SkillsHUB-Electronics/smart-fog-detector-and-illumination-v1/drivers/README.txt

Put the USB-serial driver you downloaded from the VENDOR'S OFFICIAL page here:
  - the installer (for example CH341SER.EXE), or
  - the unzipped driver folder (it contains .inf files).
Then open the dashboard > Settings > USB-serial driver and click Install.
Windows will ask for administrator approval (UAC). Nothing here is run automatically.
