SkillsHUB-Electronics/smart-fog-detector-and-illumination-v1/docs/flowchart.png

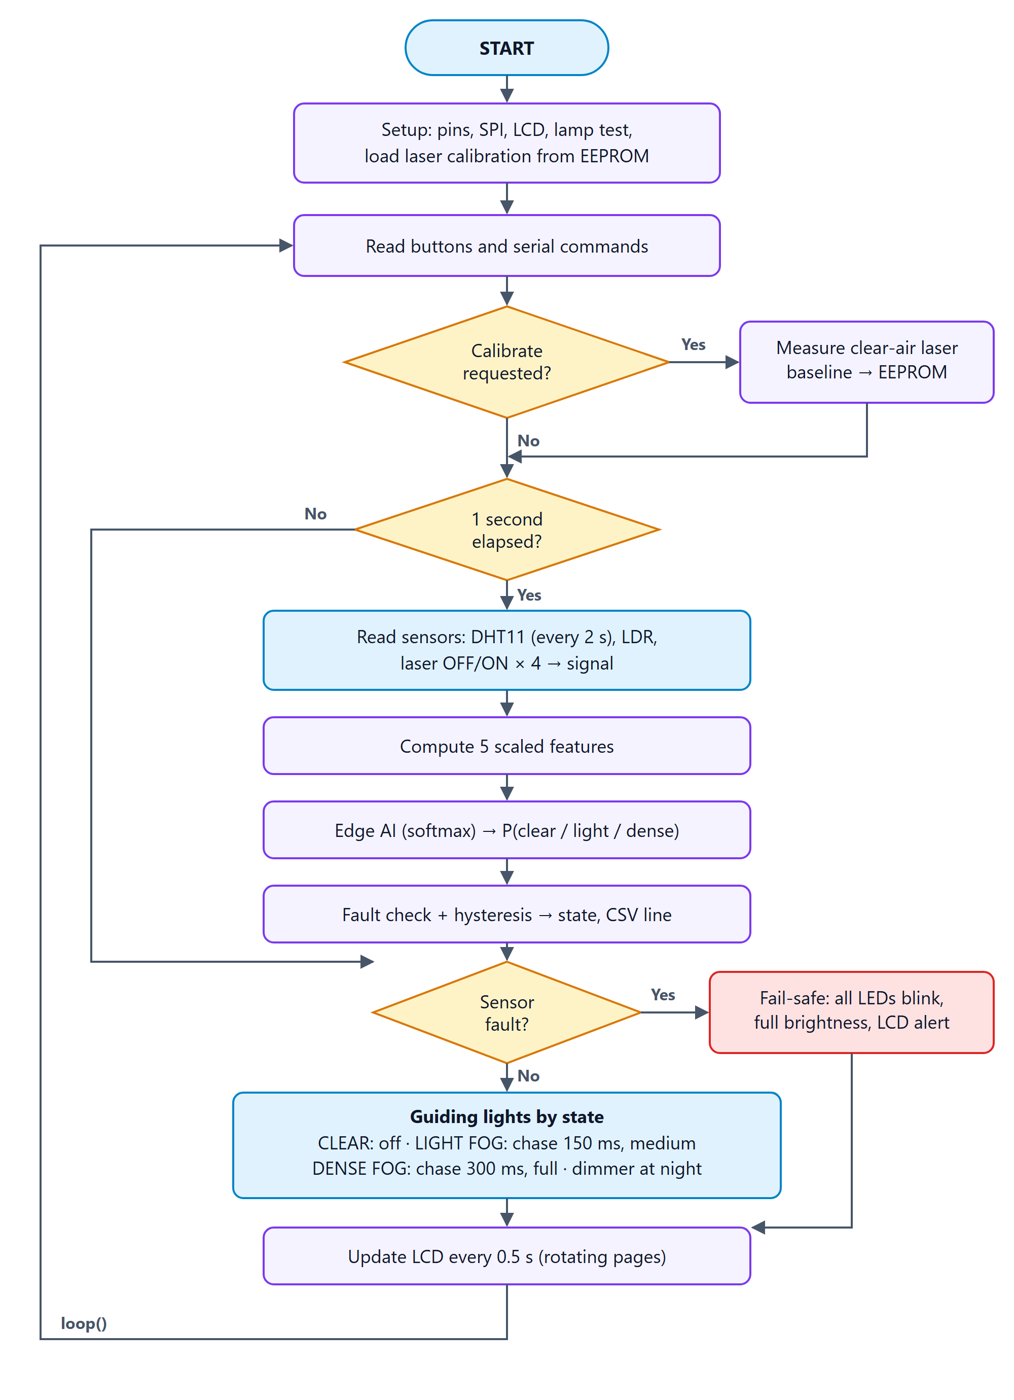
docs/flowchart.png
