SkillsHUB-Electronics/smart-fog-detector-and-illumination-v1/docs/wiring_diagram.png

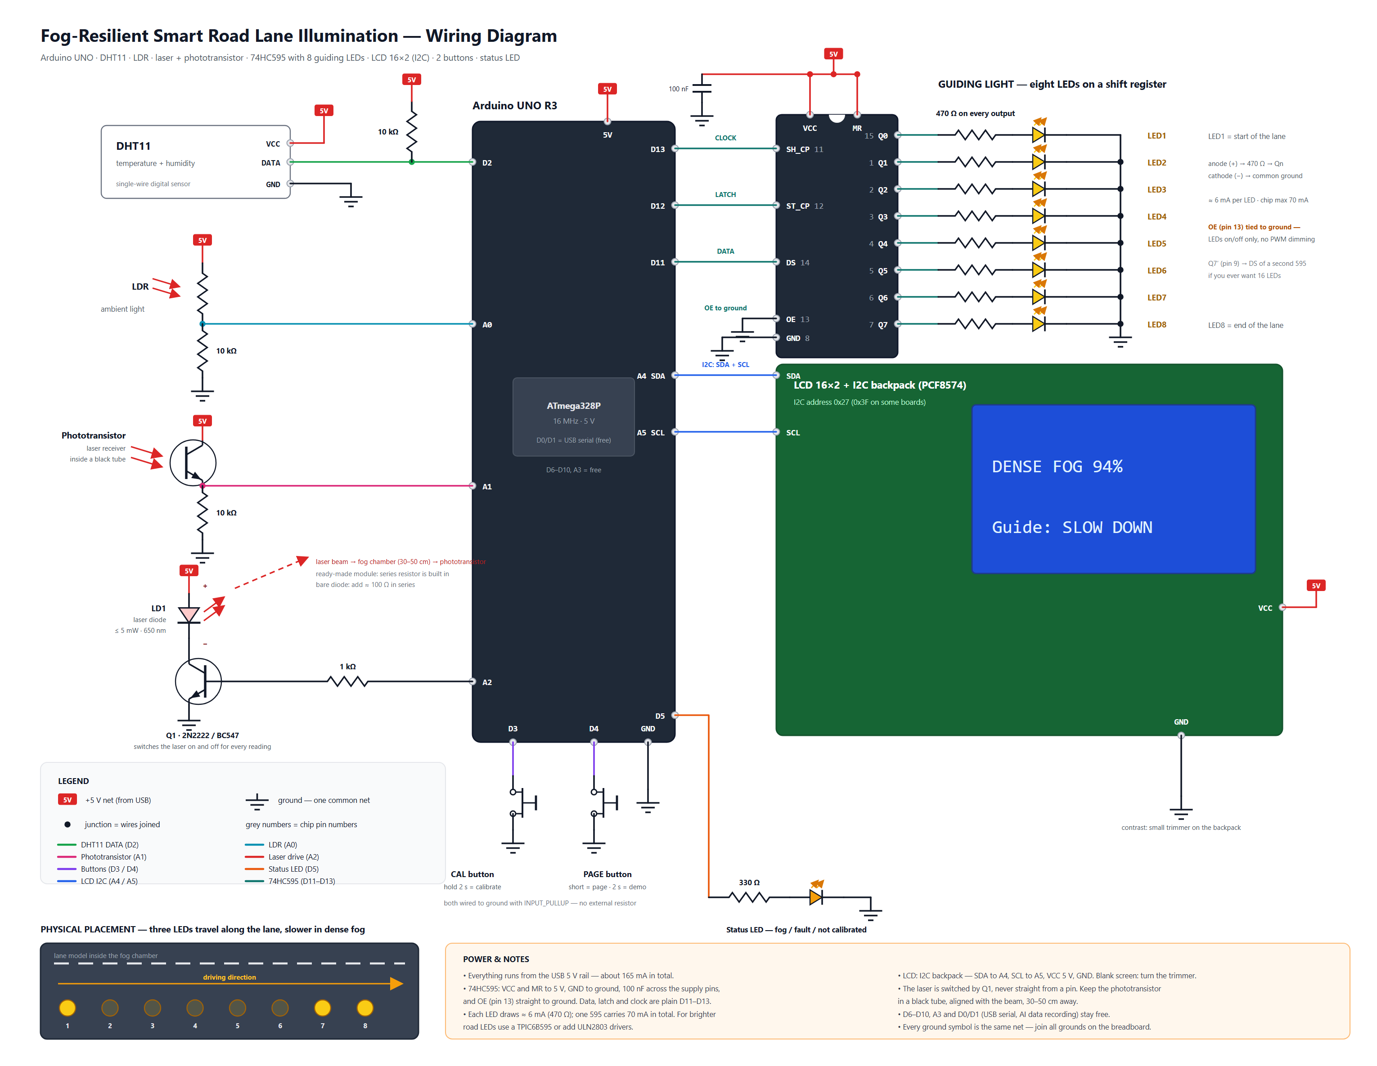
docs/wiring_diagram.png
