SkillsHUB-Electronics/smart-fog-detector-and-illumination-v1/(commit log)

2026-10-19 Smart fog detector and lane illumination: Arduino Uno firmware, tools, PC dashboard
    - firmware/fog_illumination_uno: DHT11 + laser transmission + LDR sensing, edge-AI
    (softmax) fog classifier, 74HC595 chasing guide lights, fail-safe rules,
    calibration checks, EEPROM settings over serial (!get / !set / !reset)
    - tools: serial recorder, model training, stdlib serial port access
    - dashboard: stdlib server with live view, settings over USB serial, recording,
    firmware simulator and USB-serial driver helper (START_DASHBOARD.bat)
    - docs: wiring, block and flow diagrams; README.id.md (Indonesian guide)
    [config.h, drivers.py, fog_illumination_uno.ino, model_weights.h, record_data.py, serial_port.py, server.py]
2026-10-19 Add calibration, learning and firmware upload to the dashboard
    - firmware: calibration.h (LDR limits, DHT11 gain/offset) applied to the light
    feature and the DHT11 readings; K line reports the compiled calibration
    - dashboard: Calibration page (two-point linearisation, save to calibration.h,
    compile + upload with arduino-cli), Learning page (record, train, compare
    sensors, install model_weights.h), wiring diagram and pin table in Settings
    - simulator reads the same calibration.h and applies the same formulas
    - docs: README.id.md and CLAUDE.md updated
2026-10-19 Add CI workflow: compile firmware with arduino-cli (#1)
2026-10-20 Refresh the published code graph
    Rebuilt from the current firmware (calibration, K line), tools and dashboard
    (maintenance, drivers, new pages). Still code and docs only, no proposal content.
2026-10-20 LCD to I2C, 595 on D11-D13 without OE/PWM, buttons and LED moved (#2)
    LCD uses an I2C backpack (SDA A4, SCL A5). 74HC595 clock/latch/data on D13/D12/D11
    via shiftOut, OE tied to GND (on/off only). CAL=D3, PAGE=D4, status LED=D5.
    Wiring diagram, README and CLAUDE.md updated.
2026-10-20 Add raw (unfiltered) sensor readings line and dashboard card (#3)
    * LCD to I2C, 595 on D11-D13 without OE/PWM, buttons and LED moved
    * Add R line with unfiltered sensor readings (firmware, simulator, dashboard card)
    ---------
    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
2026-10-20 Label brightness as nominal: no OE/PWM line since the 595 rewire
    Dashboard settings/scene/health/chart, README and firmware comments still
    said brightness dims the LEDs. Telemetry and settings are unchanged.
2026-10-20 Remove brightness settings, keep chase running during sensor waits, re-init LCD
    - Drop brightLight/brightDense/nightPct/nightScale and the bright column of the S line
    (no PWM line): firmware, simulator, server, dashboard, docs. EEPROM Cfg magic bumped.
    - waitMs() keeps the chase stepping during DHT/laser waits (lights held off while calibrating).
    - lcdWatch(): probe the I2C LCD every refresh, re-init when it comes back; Wire timeout.
    - Dashboard raw-reading labels explain the single receiver read with laser OFF and ON.
2026-10-20 New dashboard menu (Dashboard, Test IO, Learning, Calibration, Serial Monitor, Settings, Guide, About, Author)
    - Sidebar and pages follow the Car Distance Alarm console; Sensors merged into Dashboard,
    Log page renamed Serial Monitor; fixes the duplicate id=raw that let the history table overwrite the Raw card.
    - Test IO: firmware !io led/status/laser/lcd/off (auto-release after 30 s), simulator answers, POST /api/io.
    - Author: editable authors and supervisors with photo, ported from the Alarm System dashboard.
    - Guide and About pages. Firmware feature names moved to flash (RAM 73 %).
    [config.h, fog_illumination_uno.ino, server.py, simulator.py]
2026-10-21 Topbar like the console: page title, status, clock, theme toggle, one Connect USB button; favicon
2026-10-21 Topbar: one row, equal-height pills and buttons; banner shows last-data age instead of the duplicated link
2026-10-21 Learning page as a Record / Train / Deploy stepper
2026-10-21 Remove the Controls card (Test IO and Calibration cover it); keep the simulator scenario picker
2026-10-21 Dashboard: swap the Conditions and Device health cards
2026-10-21 Settings page: General / Device / Firmware & Ports / Wiring tabs
2026-10-21 Wiring tab: pin tiles, Zoom and Open in new tab buttons
2026-11-12 Firmware 1.2.0: run normally without I2C LCD (probe at boot, skip LCD calls)
    [fog_illumination_uno.ino]
2026-11-12 Update calibration values flashed to the board
